ChristianIannella/SmartPlug/README.md

# Arduino-SmartPlug
Arduino based smart plug 

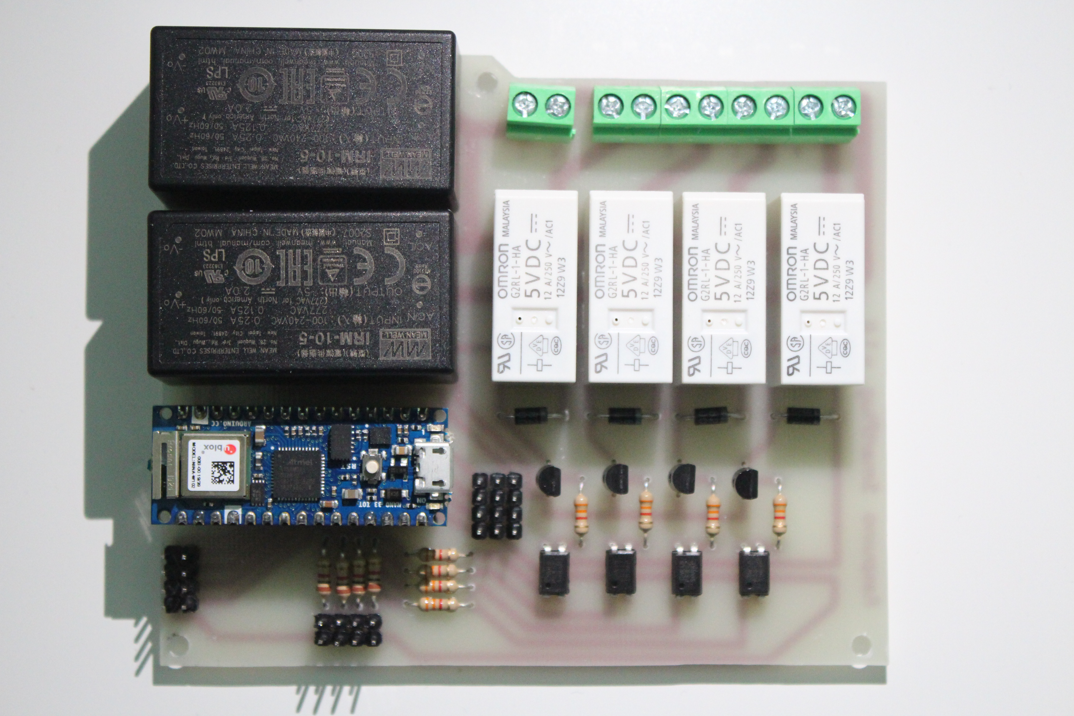
[picture p1: pcb.JPG]
Arduino SmartPlug by Iannella Christian


Super simple Alexa compatible smart plug, based on Arduino IoT Cloud.

Follow the instruction [here](https://github.com/ChristianIannella/Arduino-SmartPlug/blob/main/DIYODE-041%20SmartPlug.pdf/)

# Contribute
Please, feel free to contribute.

# Author
Iannella Christian
