ChristianIannella/SmartPlug/smartplug wiring diagram.pdf

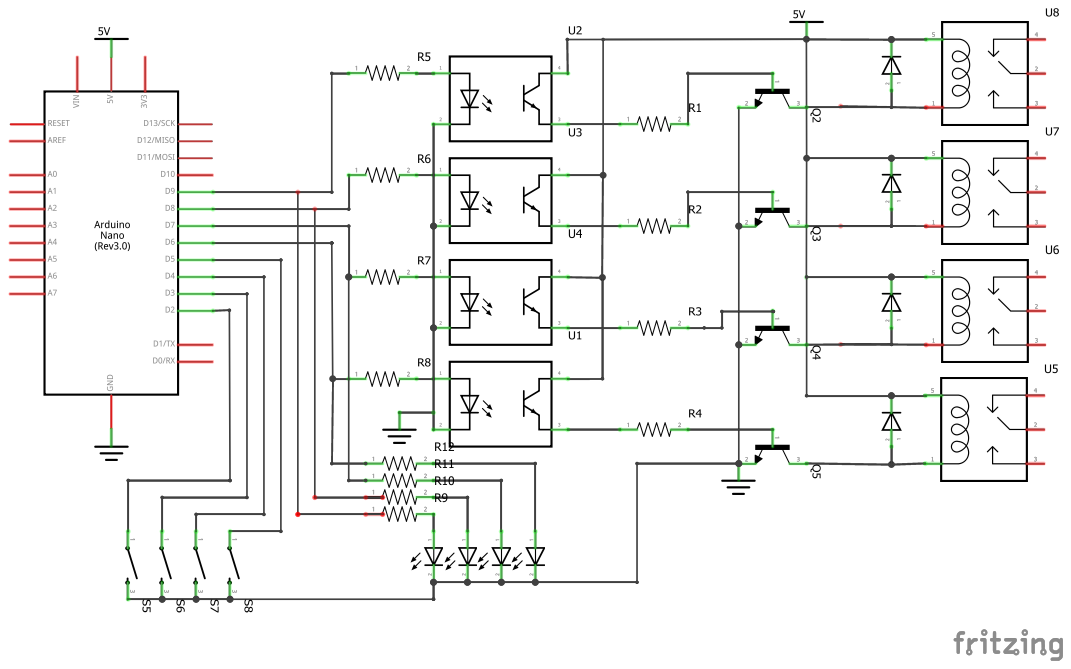
[picture p18: page 1]
