ChristianIannella/SmartPlug/Smartplug pcb.pdf

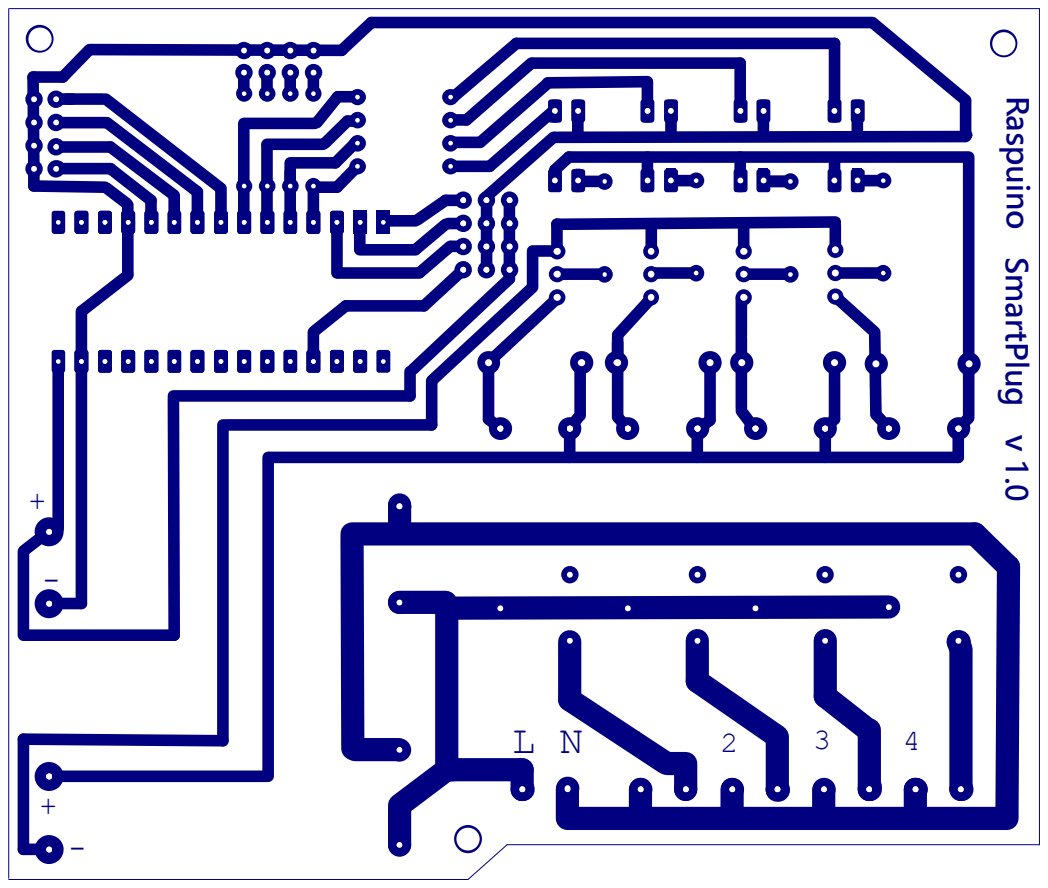
[picture p19: page 1]
Raspuino SmartPlug v 1.0 1
